xiang-wang-US/Competitive_Hovercraft/docs/Hovercraft_Case_Study.pdf

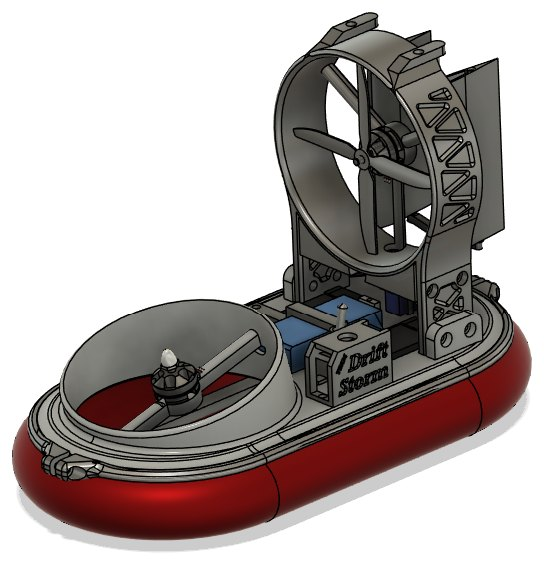
[picture p15: figure]

Context
ASME Design Team, Penn State (Team Driftstorm)

Dates
2024 to 2025 season,
competition March 2025

My role
Lead engineer

Team
16 students

Tools
Fusion 360, Fusion simulation,

weighted decision matrix

Outcome
First place, Best Hovercraft

# Competition Hovercraft

Lead engineer for a 16 person ASME team. Our

$100 radio controlled hovercraft won Best

Hovercraft for 2024 to 2025.

I led design for a 16 person team building a radio

controlled hovercraft on a $100 budget with a fixed kit

of motors and batteries. We went from a first flight

with four failure modes to a second revision that won

the competition. I ran the skirt material trade study,

set the rudder geometry, and drove the redesigns

after each test.

1st

place, Best Hovercraft 2024 to 2025
$100

budget beyond the standard kit
8 × 10

skirt trade study: materials by weighted criteria

Project

### Competition Hovercraft

Sheet title
Overview

Engineer
Xiang Wang

Date
2024 to 2025

Sheet

# Brief and constraints

Every team received the same MT2204 2300 KV

motors, 40 A ESCs, and 11.1 V LiPo battery, and

could not buy stronger replacements. Everything

else had to fit in $100 across two semesters, and

teams had to model their own reference parts

instead of importing them. The competition scored

drag races and a precision course.

The team settled on one chassis, one lift fan, one

thrust fan with twin rudders, and one skirt. I built the

reference models for the motor and skirt and

documented the wiring diagram.


2.1 First revision

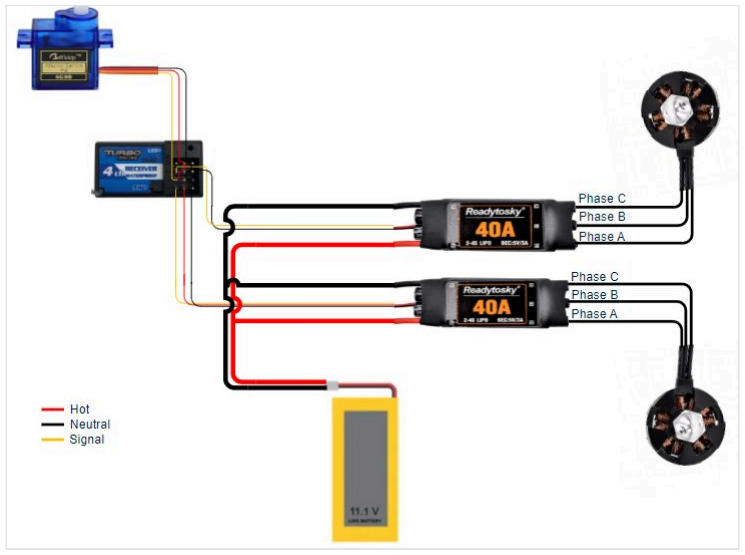
[picture p16: figure]

2.2 Wiring diagram: receiver, servos, two ESCs, lift and thrust motors

Project

Sheet title
Brief and constraints

Engineer
Date

Sheet

# Skirt material trade study

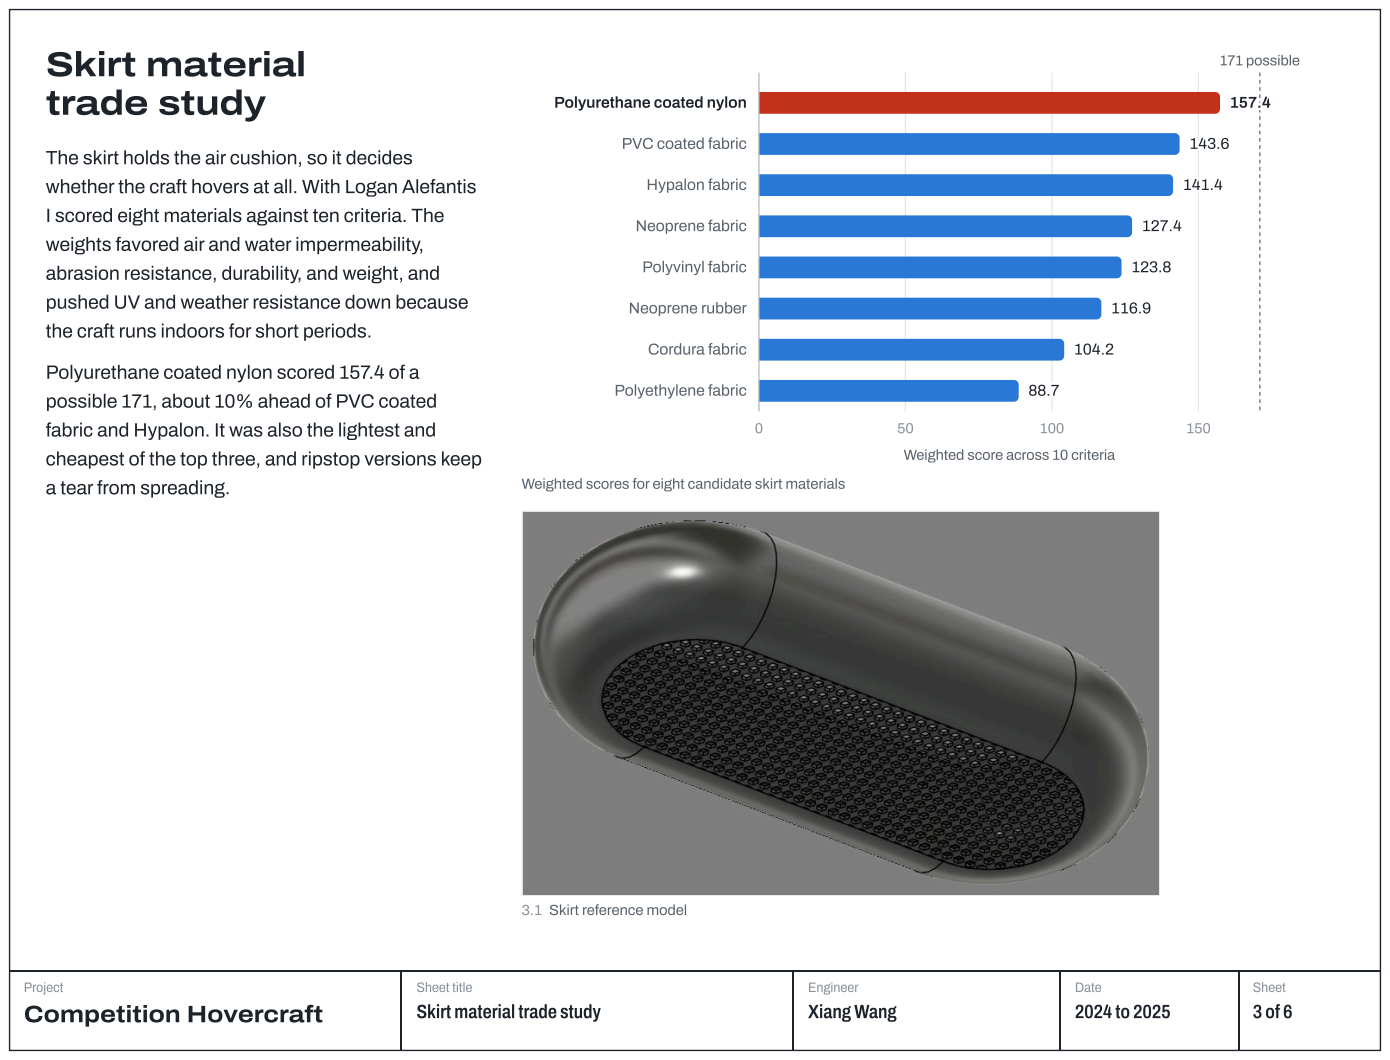
[picture p17: page 3]
171 possible; Polyurethane coated nylon; PVC coated fabric; Hypalon fabric; Neoprene fabric; Polyvinyl fabric; Neoprene rubber; Cordura fabric; Polyethylene fabric; Project; Engineer; Date; Sheet

The skirt holds the air cushion, so it decides

whether the craft hovers at all. With Logan Alefantis

I scored eight materials against ten criteria. The

weights favored air and water impermeability,

abrasion resistance, durability, and weight, and

pushed UV and weather resistance down because

the craft runs indoors for short periods.

Polyurethane coated nylon scored 157.4 of a

possible 171, about 10% ahead of PVC coated

fabric and Hypalon. It was also the lightest and

cheapest of the top three, and ripstop versions keep

Weighted score across 10 criteria

a tear from spreading.

Weighted scores for eight candidate skirt materials

3.1 Skirt reference model

Sheet title
Skirt material trade study

# Rudders and steering

A vector sketch of the thrust stream across a

deflected rudder showed the turning force peaks at

45 degrees. I capped rudder travel at plus or minus

45 degrees, so the servos and linkage only had to

cover that range.

The plastic rudder pins kept breaking, so titanium

rods replaced them for about $7. I also designed a

custom servo horn with the spline modeled in,

replacing the supplied horn to save parts, assembly,

and weight. The spline was too small to measure

directly, so I took a reference diameter and drew the

teeth by hand in CAD. FDM printers could not hold

the teeth, so the horn needed resin printing.


4.1 Thrust deflection sketch used to

set travel


4.2 Rudders at the 45 degree limit


4.3 Custom servo horn spline

Project

Sheet title
Rudders and steering

Engineer
Date

Sheet

# First flight and redesign

The first flight showed four problems: the craft

bobbed, thrust pushed the bow into the floor, the

angled lift fan behaved unpredictably, and the skirt

pulled out of its clamp. Looking at the clamp, force

concentrated near the fasteners and left the long

edges loose, so I proposed a continuous clamp with

a compliant strip pressing the skirt evenly.

Revision two changed three things: a flat fan

instead of the angled one, better component

placement, and an angled propeller. I proposed an

isogrid propulsion duct to cut weight, reworked the

rudder, servo, and leg mounts, and removed a bulky

part that was not needed, checking the lighter

structure in simulation.

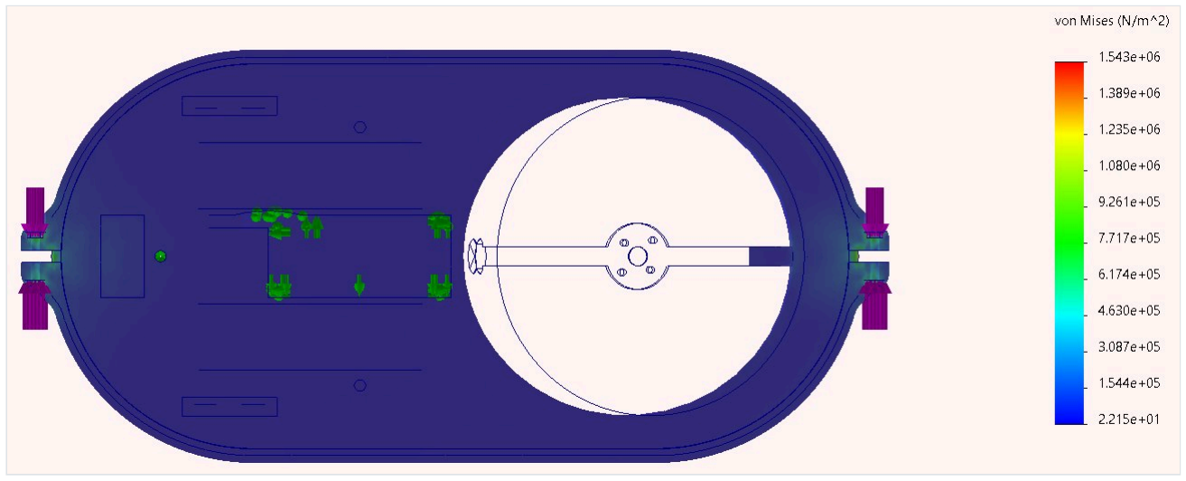
[picture p18: figure]

5.1 Clamp load: force only near the ends

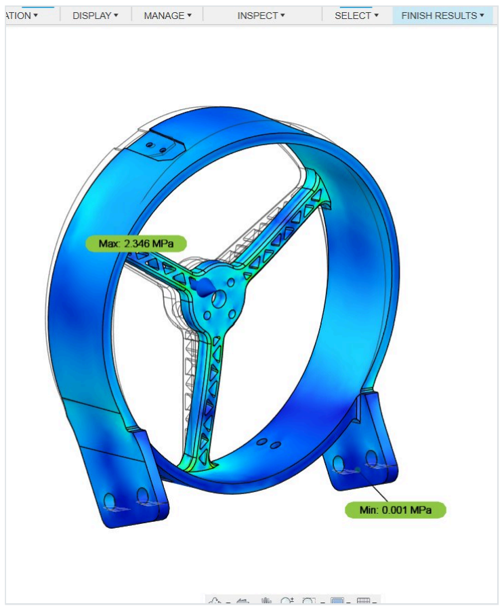
[picture p19: figure]

5.2 Isogrid thrust duct | 5.3 Duct stress check

Project

Sheet title
First flight and redesign

Engineer
Date

Sheet

# Testing and result

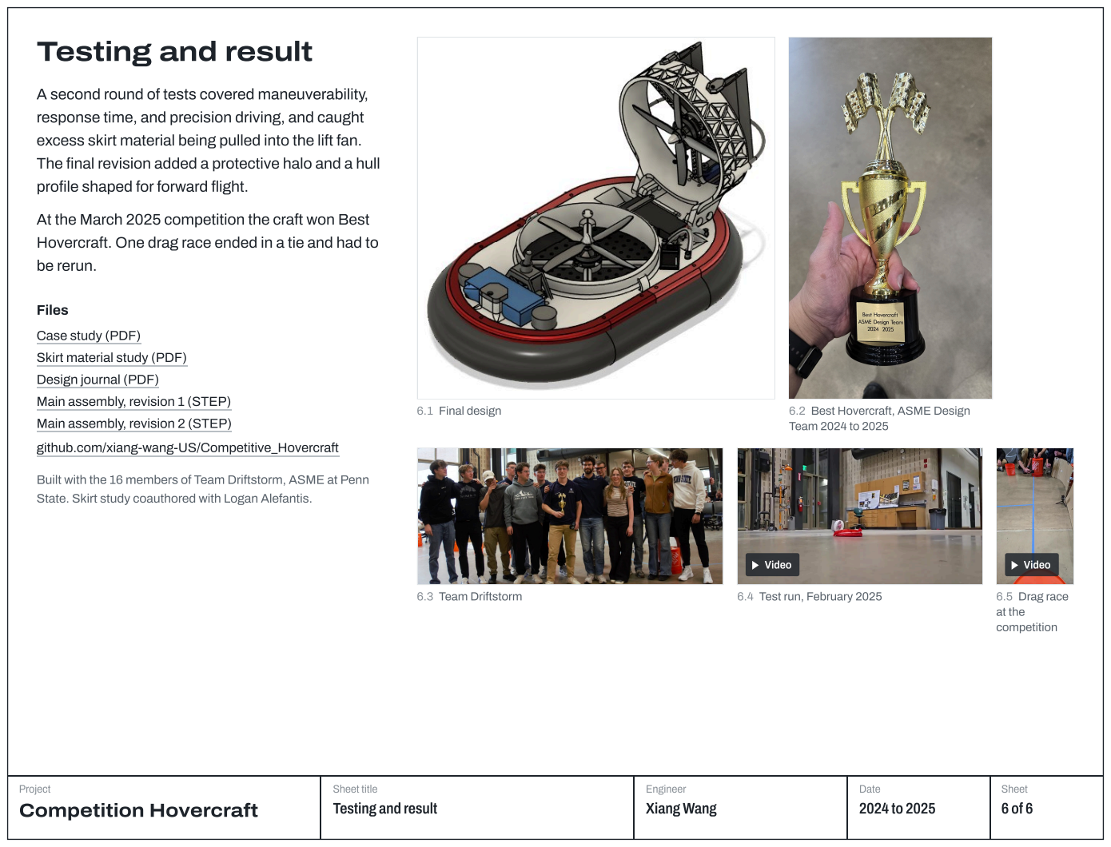
[picture p20: page 6]
be rerun.; Files; 6.1 Final design; 6.2 Best Hovercraft, ASME Design; Team 2024 to 2025; 6.3 Team Driftstorm; 6.4 Test run, February 2025; 6.5 Drag race; at the; competition; Project; Engineer; Date; Sheet; Video

A second round of tests covered maneuverability,

response time, and precision driving, and caught

excess skirt material being pulled into the lift fan.

The final revision added a protective halo and a hull

profile shaped for forward flight.

At the March 2025 competition the craft won Best

Hovercraft. One drag race ended in a tie and had to

Case study (PDF) (https://github.com/xiang-wang-US/Competitive_Hovercraft/blob/main/docs/Hovercraft_Case_Study.pdf)

Skirt material study (PDF) (https://github.com/xiang-wang-US/Competitive_Hovercraft/blob/main/docs/Hovercraft_Skirt_Material_Study.pdf)

Design journal (PDF) (https://github.com/xiang-wang-US/Competitive_Hovercraft/blob/main/docs/Hovercraft_Design_Journal.pdf)

Main assembly, revision 1 (STEP) (https://github.com/xiang-wang-US/Competitive_Hovercraft/blob/main/cad/Hovercraft_Main_Assembly_V1.step)

Main assembly, revision 2 (STEP) (https://github.com/xiang-wang-US/Competitive_Hovercraft/blob/main/cad/Hovercraft_Main_Assembly_V2.step)

github.com/xiang-wang-US/Competitive_Hovercraft

Built with the 16 members of Team Driftstorm, ASME at Penn

State. Skirt study coauthored with Logan Alefantis.

Sheet title
Testing and result
