xiang-wang-US/Competitive_Hovercraft/cad/Hovercraft_Main_Assembly_V2.step

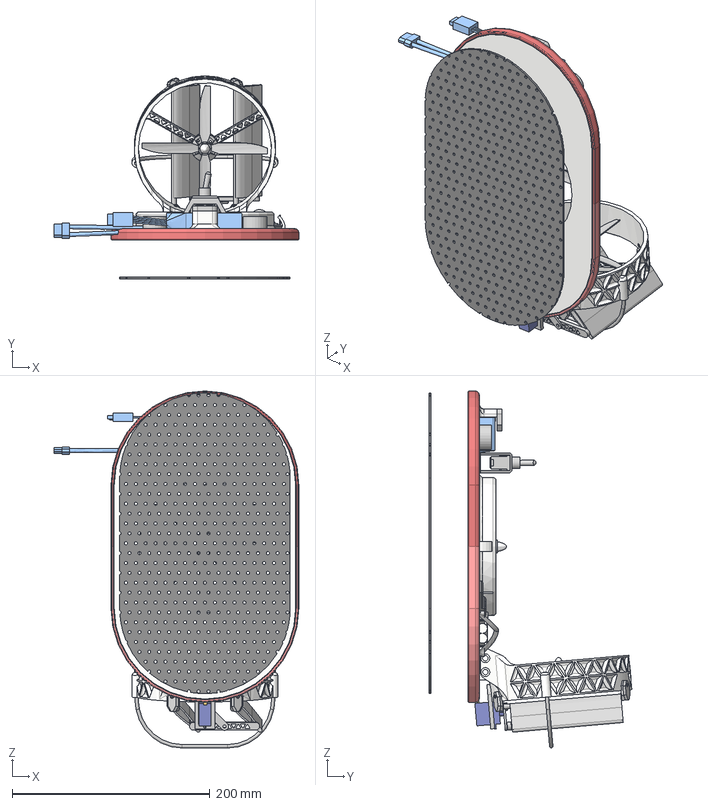
[picture p22: CAD file, 2026-10-12]
cad/Hovercraft_Main_Assembly_V2.step
247.8 x 205.7 x 361.5 mm
MT2204 2300 KV - Xiang x 2
4 Blade Propellers - Jess Portman x 2
Penny Caps x 2
Penny-Alex x 2
Battery Cap
O-Ring
Battery Reference Part
ESC refrence part2 x 2
Reference Receiver- Matthew Devonshire
Kill Switch - Logan Alefantis
Skirt Model V2 - Alex
KIll Switch Mount V2 - Logan Alefantis
Propulsion Bracket Rudder Mount B x 2
Propulsion Bracket Rudder Mount A x 2
M3 Washer x 5
Aileron x 2
EXP - Servo Horn Driver Unit
Titanium Rod M3x128.5 x 2
M2x6 x 4
Motion Linkage Bracket
Clamp Redesign- Evan
