xiang-wang-US/Competitive_Hovercraft/cad/Hovercraft_Main_Assembly_V1.step

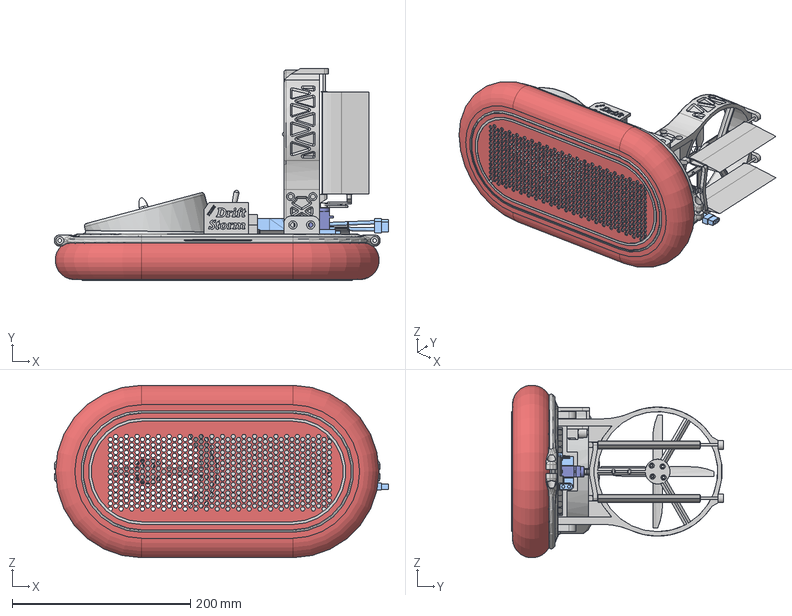
[picture p23: CAD file, 2026-10-12, an earlier design]
cad/Hovercraft_Main_Assembly_V1.step
375.3 x 238.3 x 193.7 mm
Skirt Model - PM - Xiang Wang
MT2204 2300 KV - Xiang x 2
ESC refrence part2 x 2
Battery Reference Part
Reference Receiver- Matthew Devonshire
skirt shape retainer idea - Jess Portman
Electronics Bracket - George Kuney
Skirt Clamp Remake- George Kuney
M3 Washer x 6
EXP-Propulsion Servo Bracket
EXP-Propulsion Bracket
4 Blade Propellers - Jess Portman
Aileron x 2
EXP-Servo Motor Horn Adapter B
EXP-Servo Motor Horn Adapter A
EXP-Aileron Driver Bracket
EXP-Aileron Mounting Bracket x 2
Kill Switch Mount - Logan Alefantis
Kill Switch - Logan Alefantis
