xiang-wang-US/Competitive_Hovercraft/docs/Hovercraft_Design_Journal.pdf

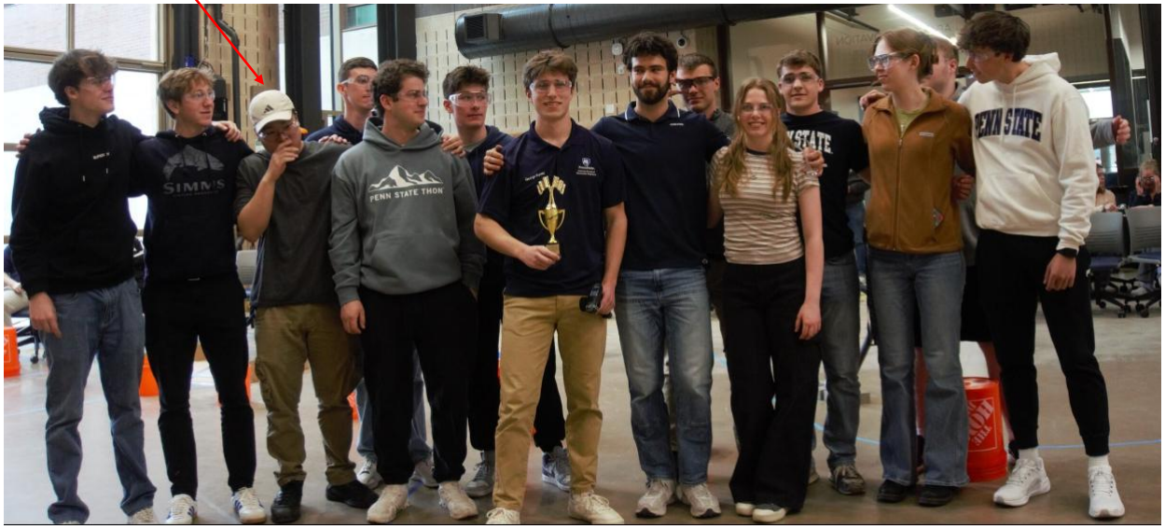
[picture p69: figure]
