xiang-wang-US/Competitive_Hovercraft/docs/Hovercraft_Design_Journal.pdf

# Hovercraft Competition

## ASME PSU 2025 From the perspectives of Xiang

# Preface

- This document is not necessarily formatted in any particular way.

## - It contains:

## - Documented work - Explanations to others - General Progress

## - It mostly contains my perspective on how the project progressed - Some major time stamps have been noted for story purposes

# Competition Detail

## - Each team are given a standard set of parts

## - Motors, Batteries, ESCs

## - Not allowed to buy stronger standard parts - Can rebuy fried parts and will not count toward budget - 100 USD - 2 semesters - No importing reference parts

# Brainstorming Session

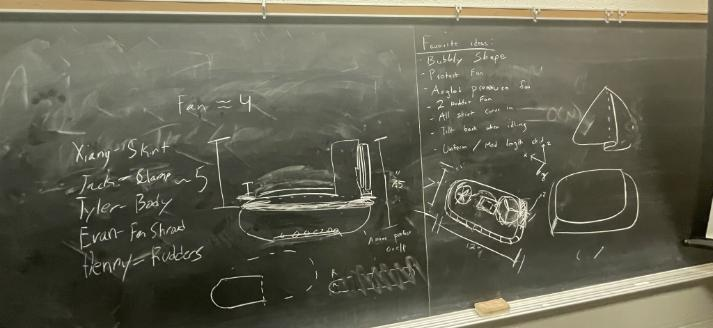
[picture p24: figure]

# Brainstorming Session Summary

## - The hover craft will have - 1 Chassis - 1 Propeller Fan - 1 Lift fan - 1 Skirt

## We like having a rudder, angled lift fan, and forward lift fan

# Making Reference Parts (MT2204 – 2300 KV)

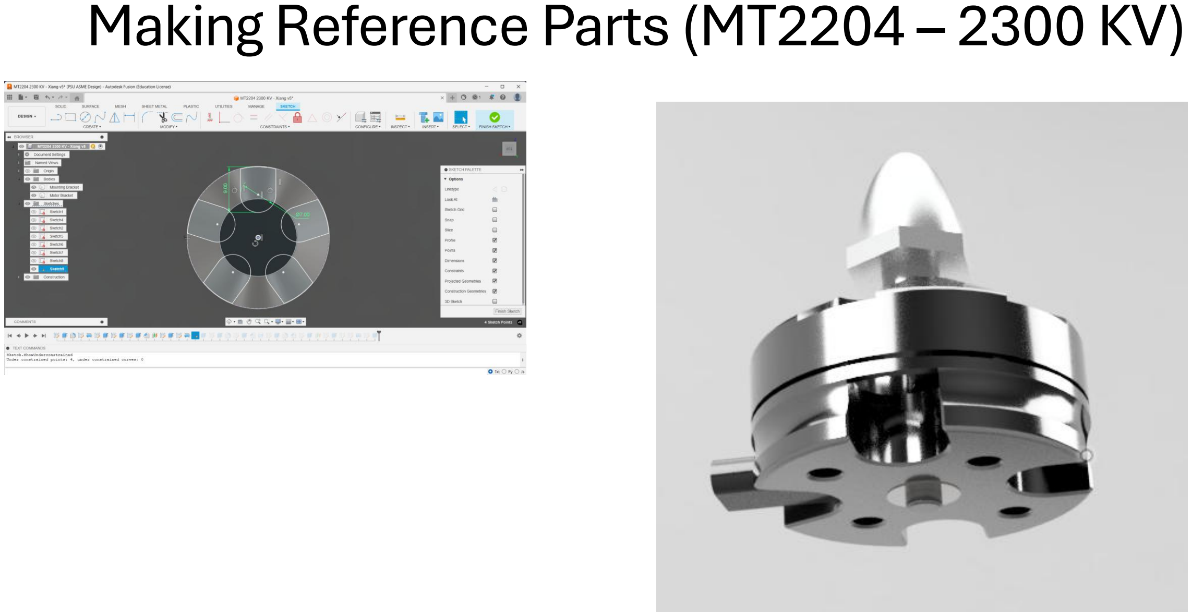
[picture p25: page 6]

# Making the Skirt Reference

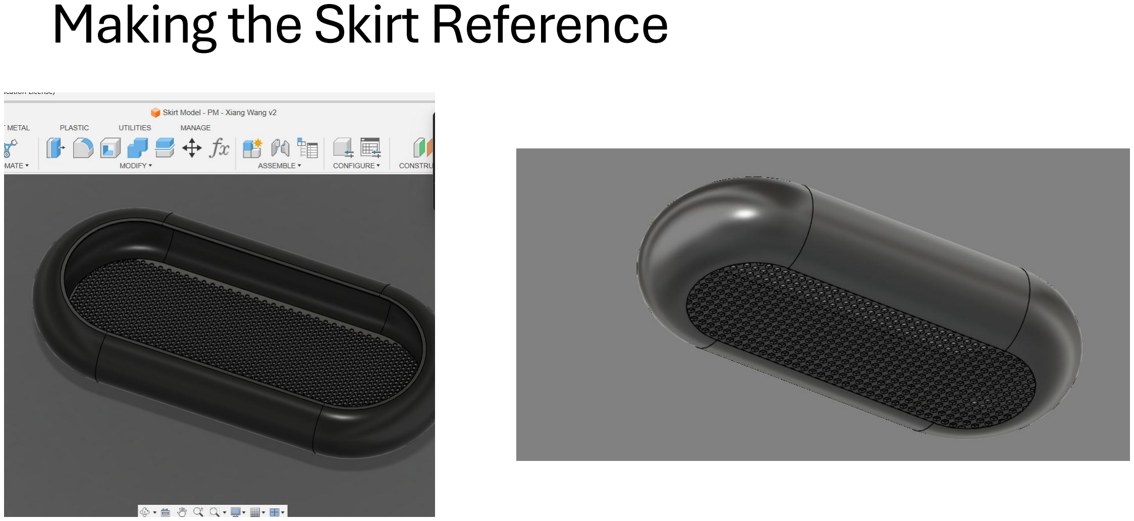
[picture p26: page 7]

# Wiring Diagram

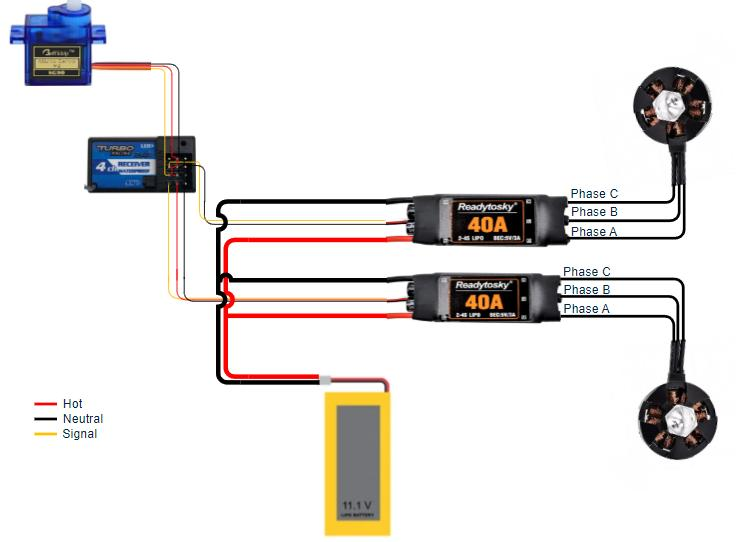
[picture p27: figure]

# Does this work?

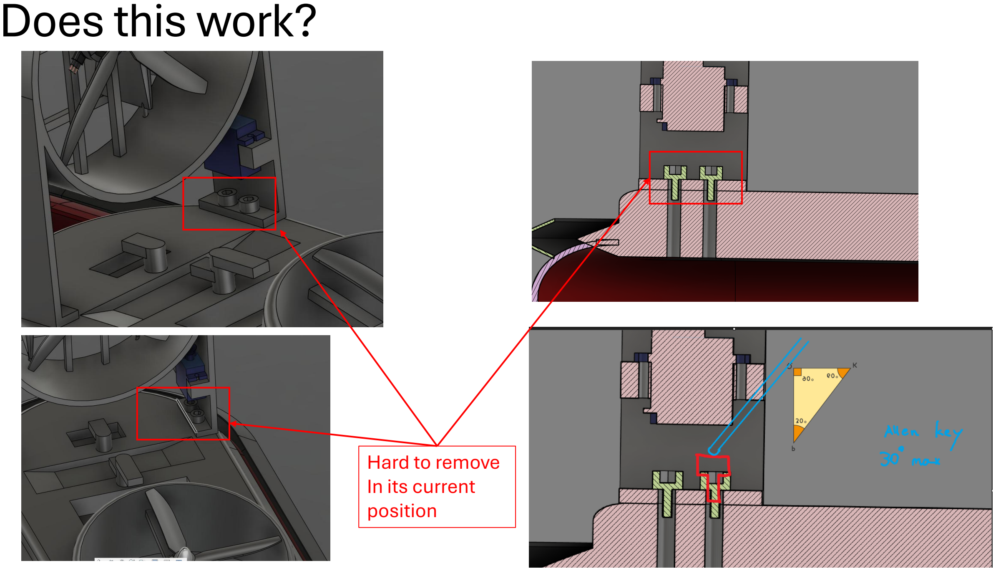
[picture p28: page 9]

Hard to remove
In its current
position

# Let’s remove these

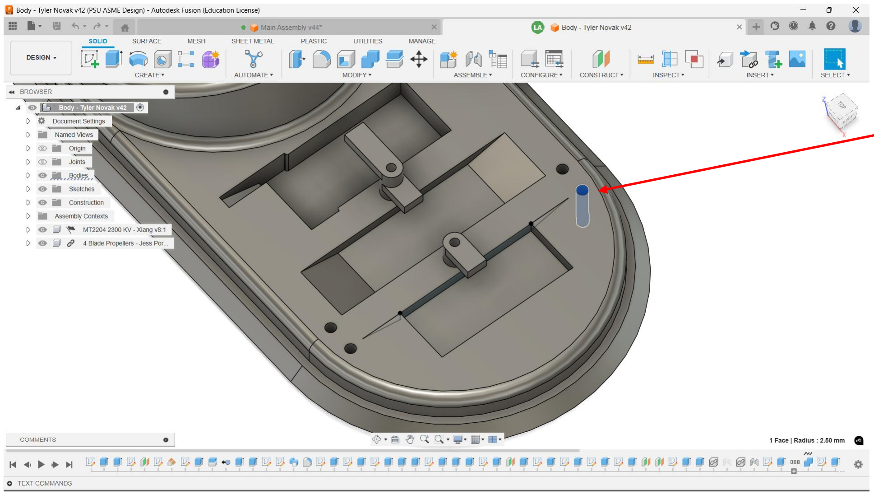
[picture p29: figure]

Let’s
change
these

# Raised Mounting Point Suggestion

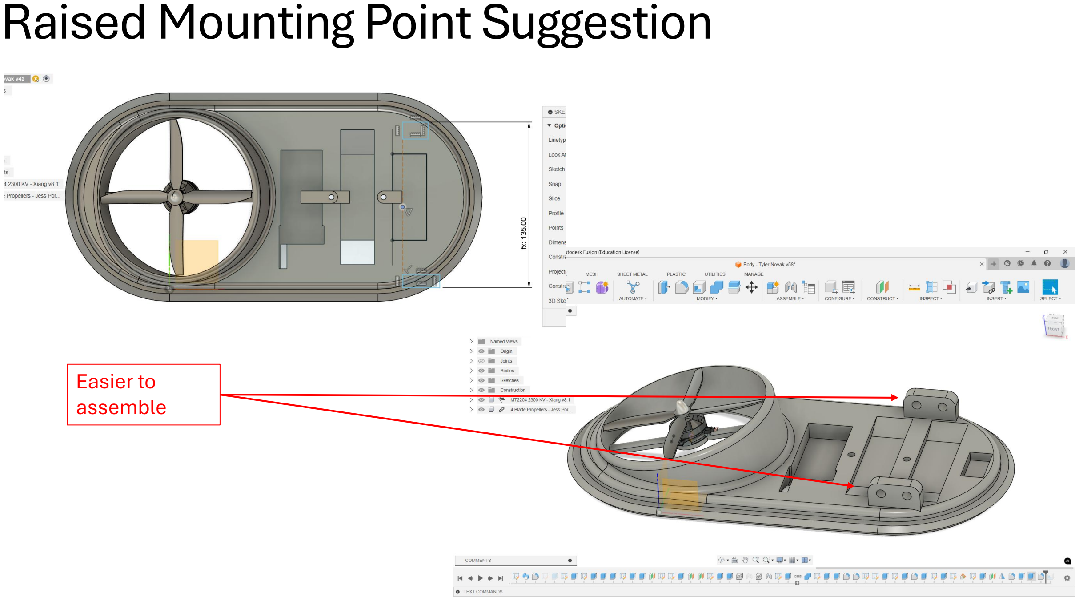
[picture p30: page 11]

Easier to
assemble

# Maximum angle needs

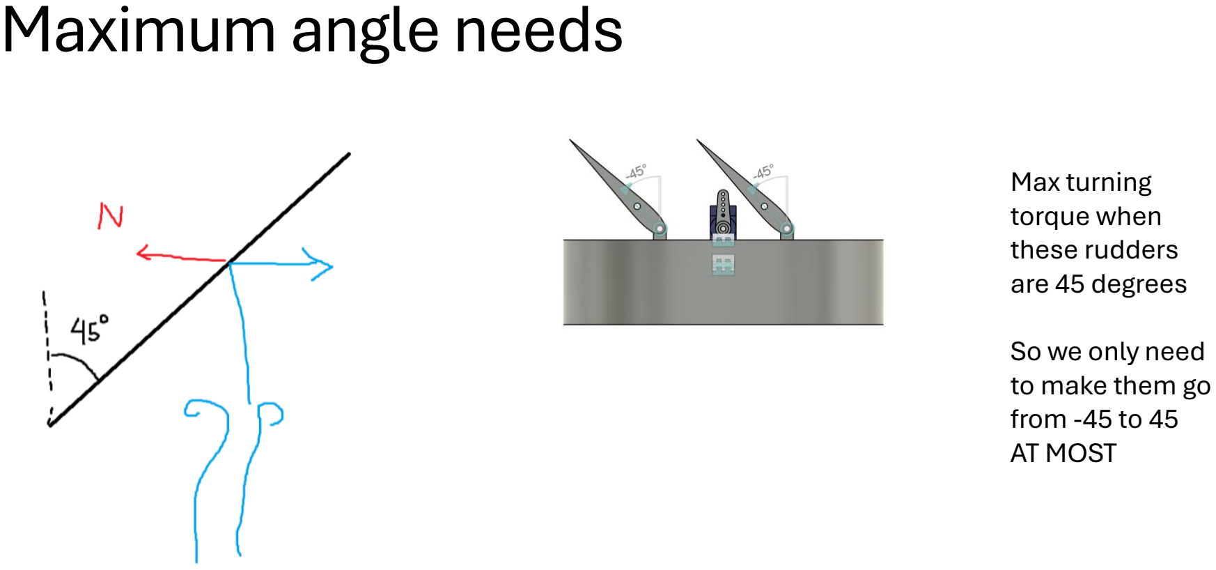
[picture p31: page 12]

Max turning
torque when
these rudders
are 45 degrees

So we only need
to make them go
from -45 to 45
AT MOST

# V1 Completion

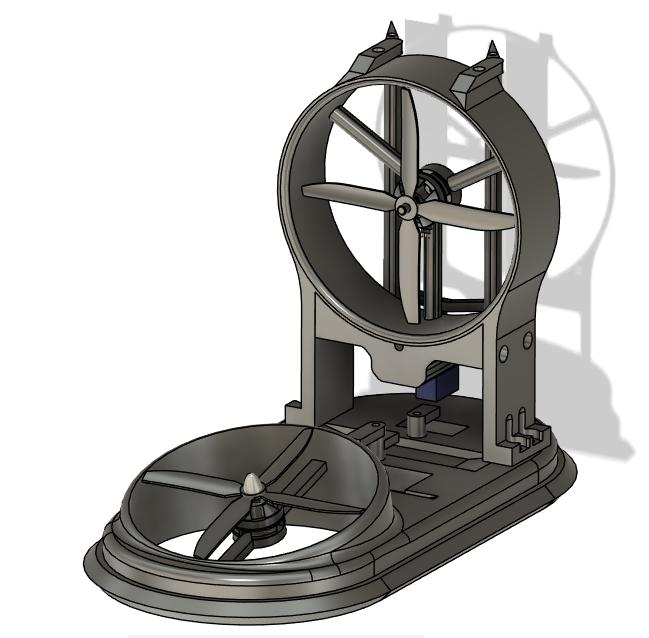
[picture p32: figure]

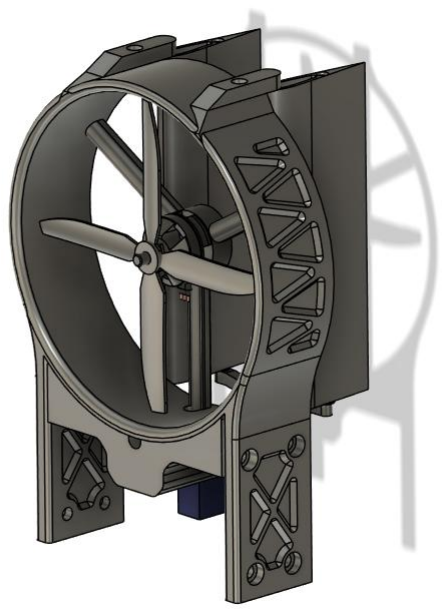
[picture p33: figure]

# Isogrids Proposal?

- May help with weight
reduction
- Looks kind of cool

# Current Component Layout

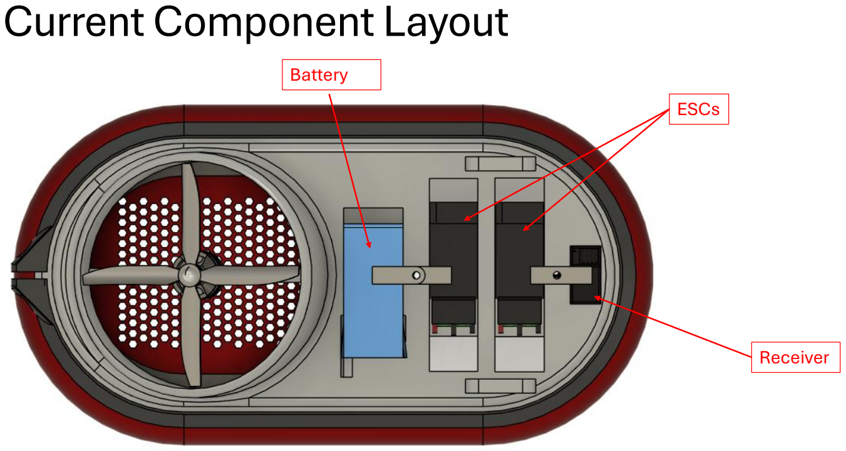
[picture p34: page 15]

ESCs

Receiver

Battery

# Component Interference

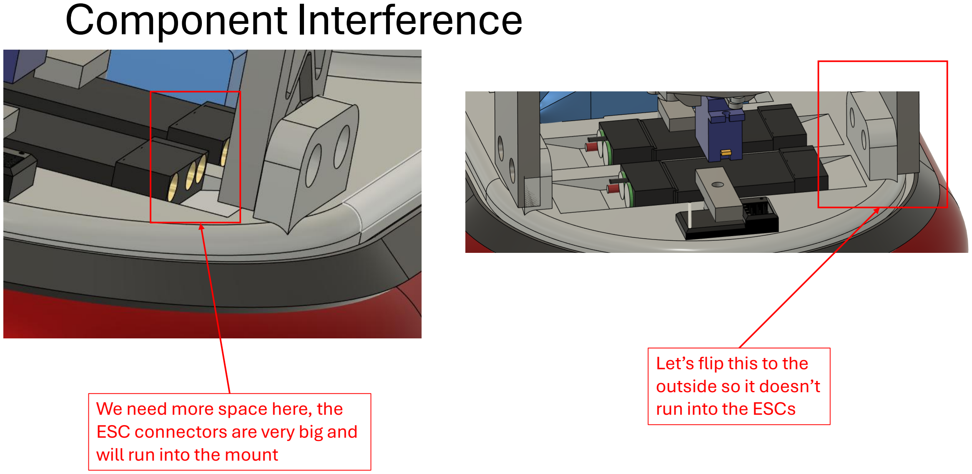
[picture p35: page 16]

We need more space here, the ESC connectors are very big and will run into the mount

Let’s flip this to the
outside so it doesn’t
run into the ESCs

# First flight!

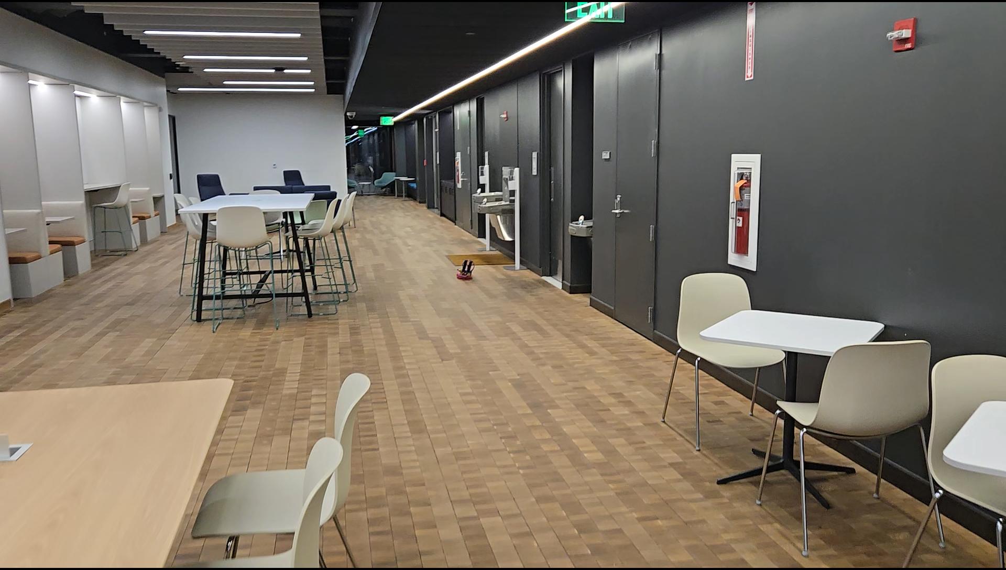
[picture p36: figure]

# First Flight Issues

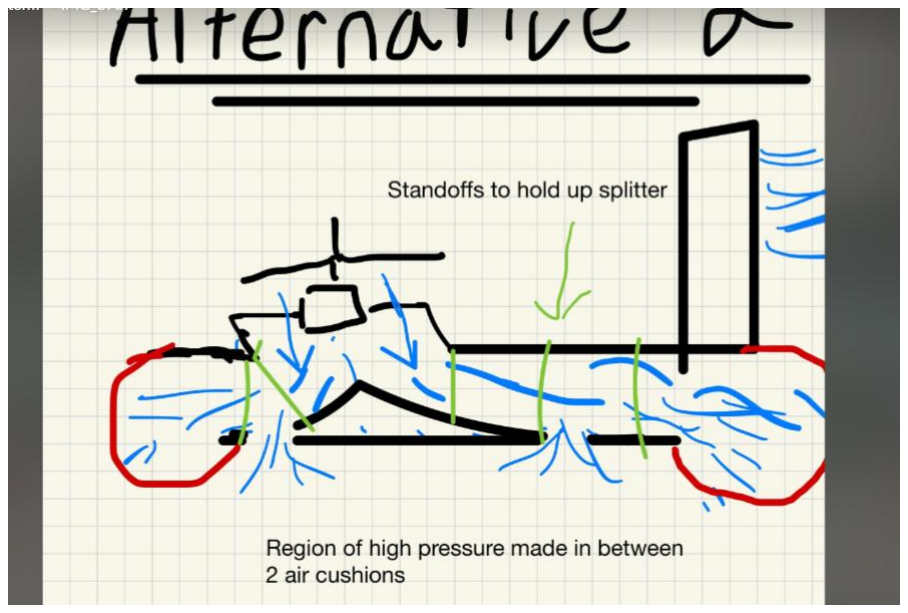
[picture p37: figure]

The propeller were pushing the hovercraft into the
ground.

Angled lift fan was also kind of odd

The hovercraft skirt kept
coming out

Bobbing issue, maybe this might help

# Clamping Force Issues

This fan design only
applies force near the
ends

Little to no force
here

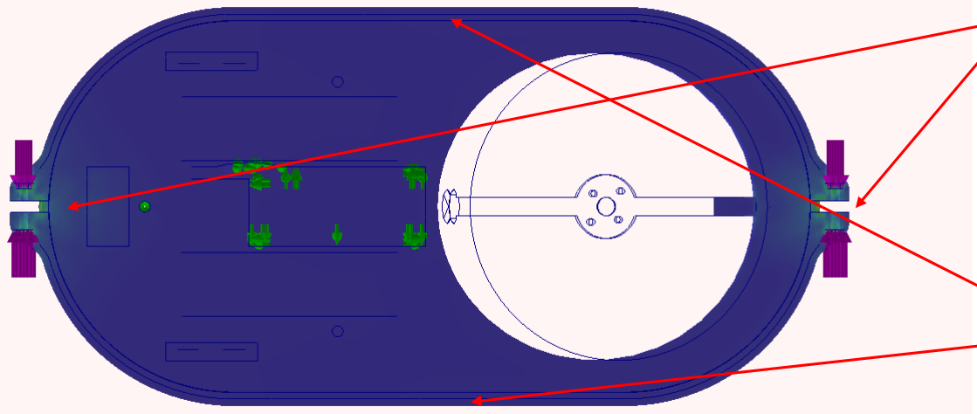
[picture p38: figure]

This reminds me of the problem I saw in this video from years ago lol https://youtu.be/1RJunnhpFIM

# Clamping redesign force proposal

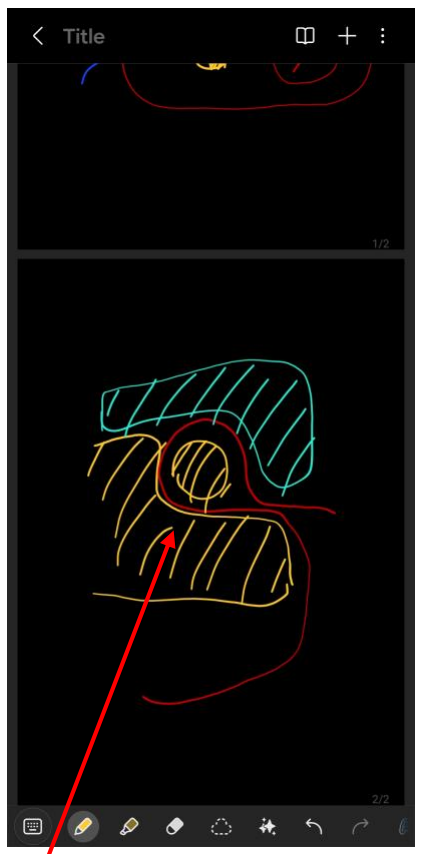
[picture p39: figure]
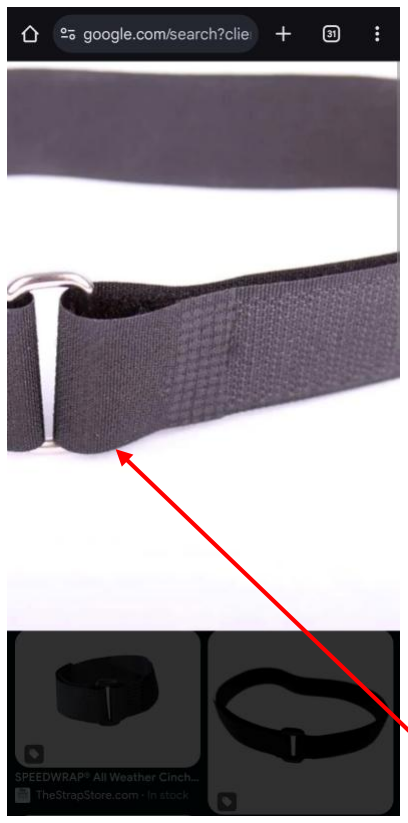
[picture p40: figure]

What if we did something
like this

Red is skirt

Yellow is chassis

Cyan is new clamp

And the circle is
some squishy
material to press of
it together

# Part too bulky

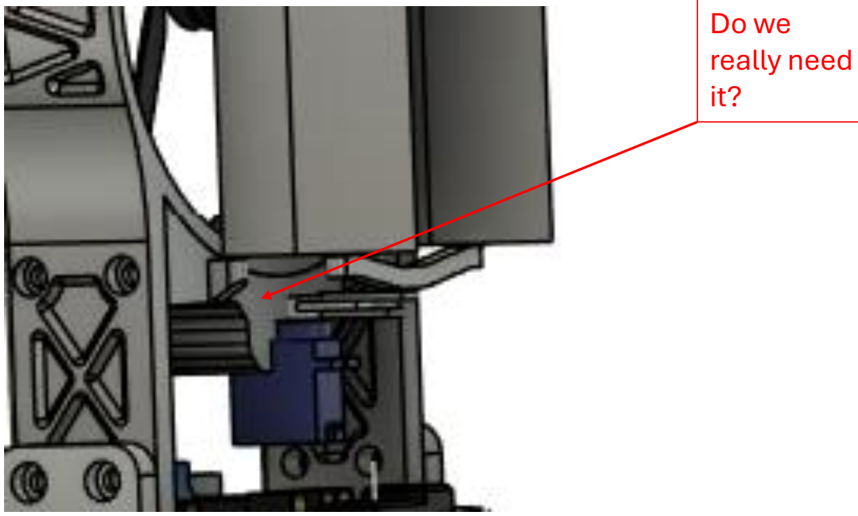
[picture p41: figure]
Do we really need it?

Benefits:
- Reduced weight
- Simplified parts
- Less assembly

Work:
- Need to make sure the legs are still strong (FEA?)

# New Propulsion Bracket Design Proposal

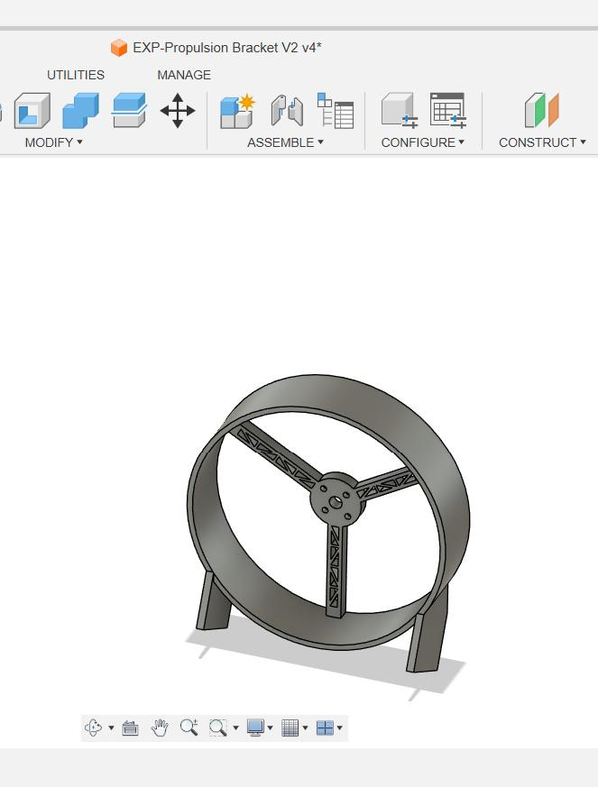
[picture p42: figure]

Redo
- Rudder Mount
- Servo Mount
- Leg Mount

# Isogrid Continuity Issue

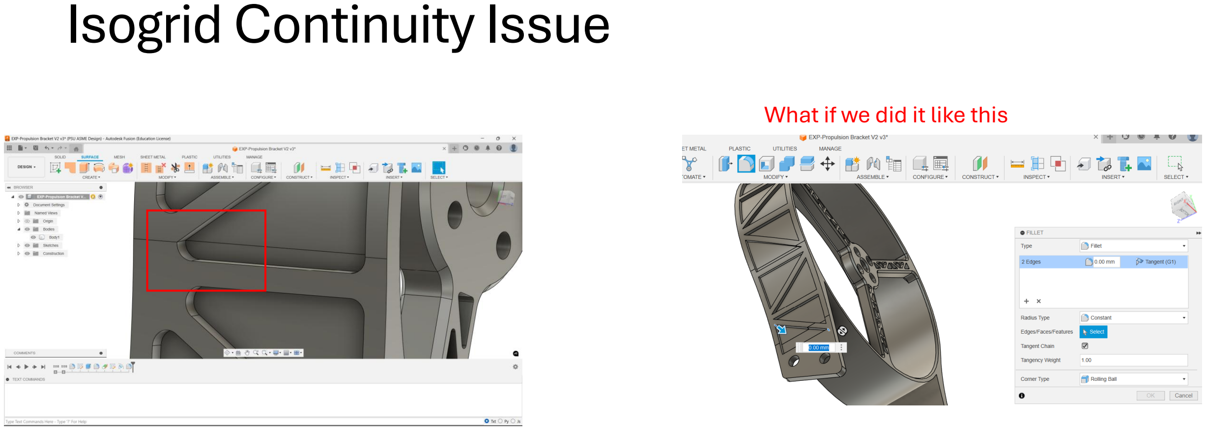
[picture p43: page 23]

What if we did it like this

# Isogrid Redesign

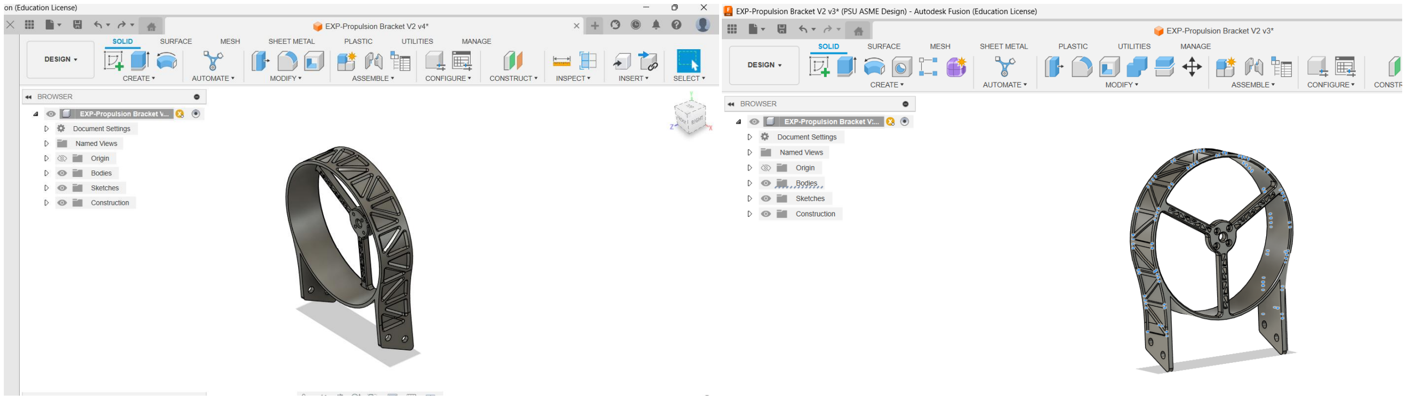
[picture p44: figure]

# Isogrid Redesign

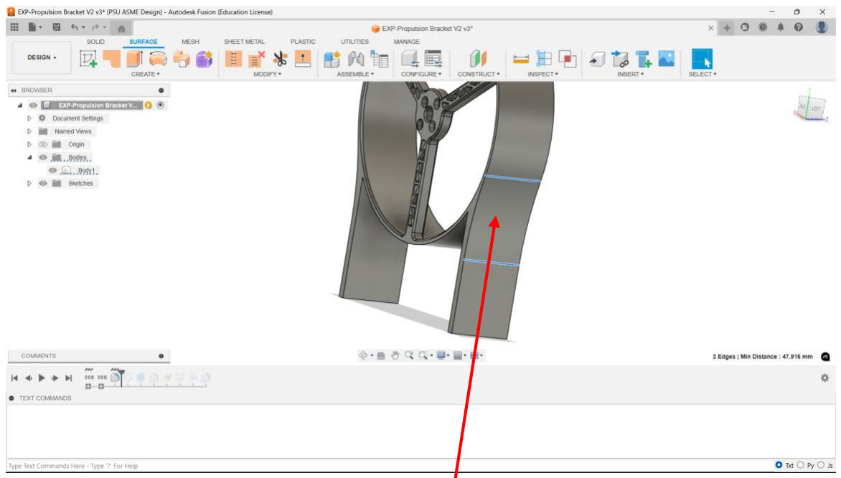
[picture p45: figure]

Nevermind isogrid can
be fixed by increasing
the radii here

# Redesigning the servo horn

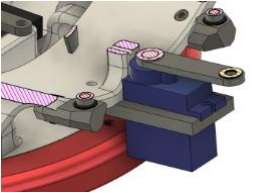
[picture p46: figure]

Benefits
- Much simpler. No more horn that was shipped with manufacturer.
- Reduced assembly
- Weighs less

Work
- We need to actually be able to manufacture it. No FDM printing; not enough resolution. Possible resin?

# We need custom Servo Horn

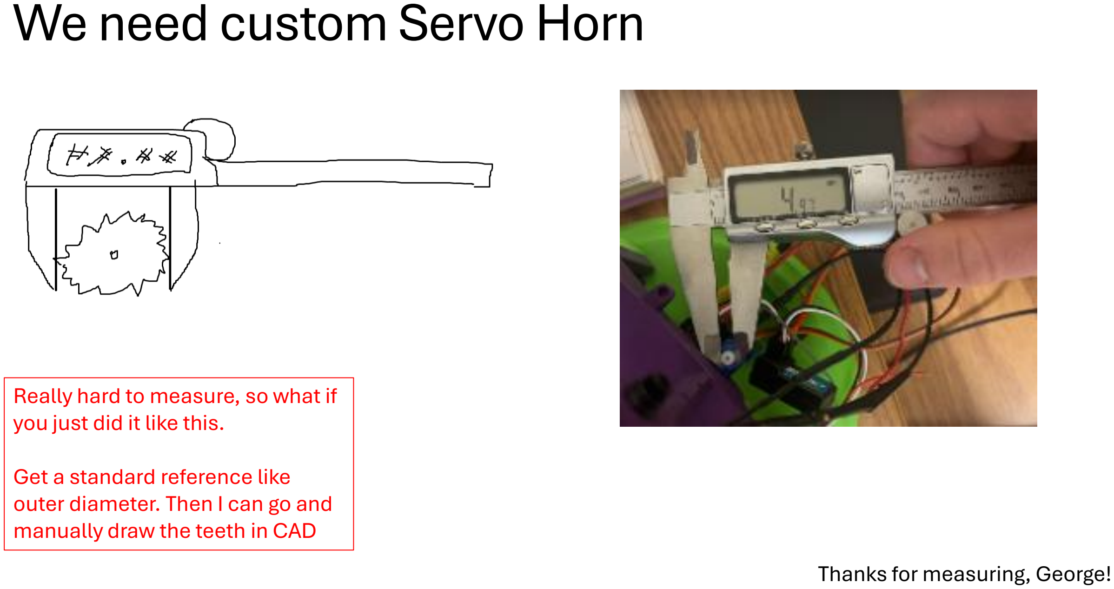
[picture p47: page 27]

Really hard to measure, so what if you just did it like this.

Get a standard reference like outer diameter. Then I can go and manually draw the teeth in CAD Thanks for measuring, George!

# Servo Spline Profile

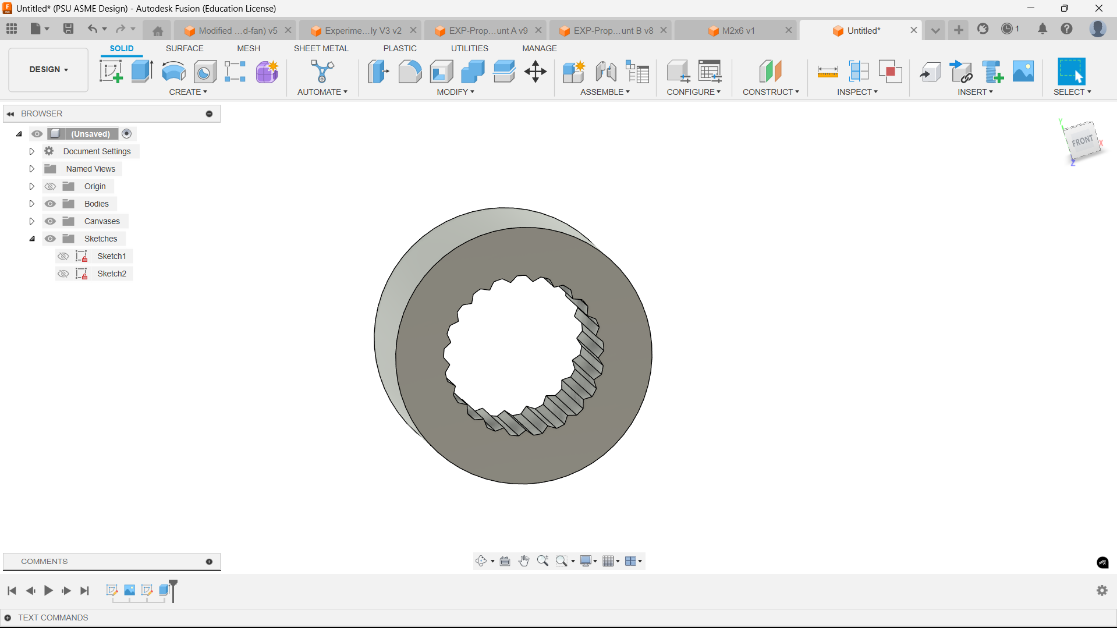
[picture p48: figure]

# Propulsion Bracket Recommendations

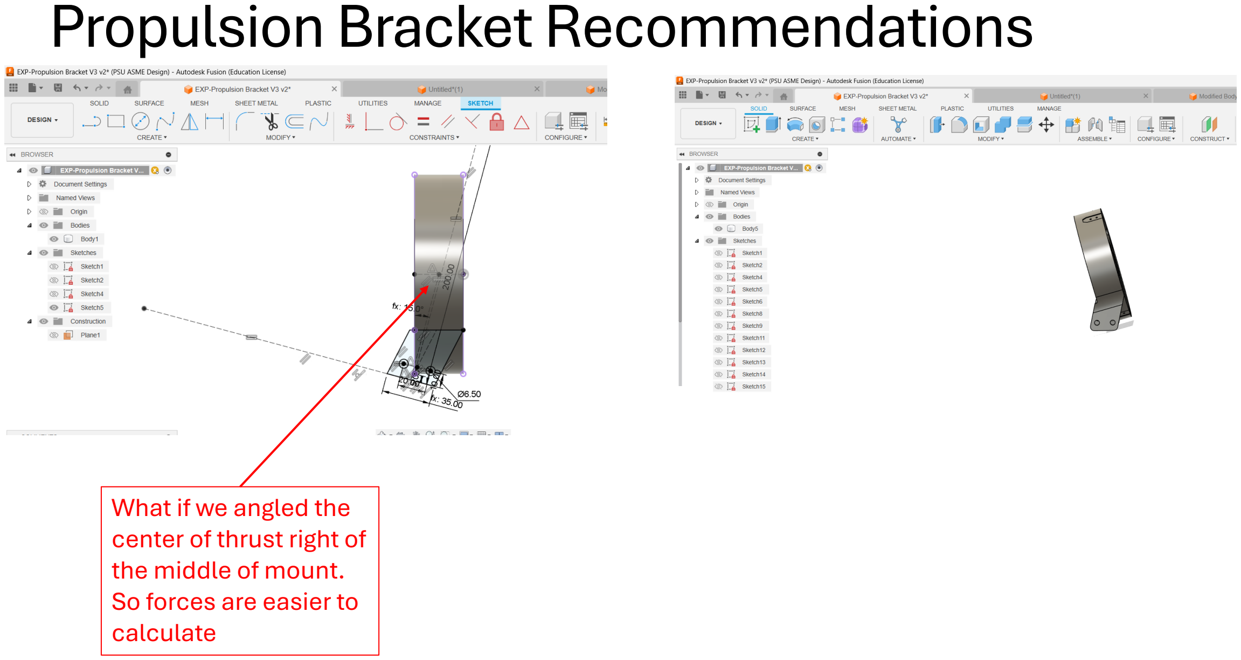
[picture p49: page 29]

What if we angled the
center of thrust right of
the middle of mount.
So forces are easier to
calculate

# V2 Changes

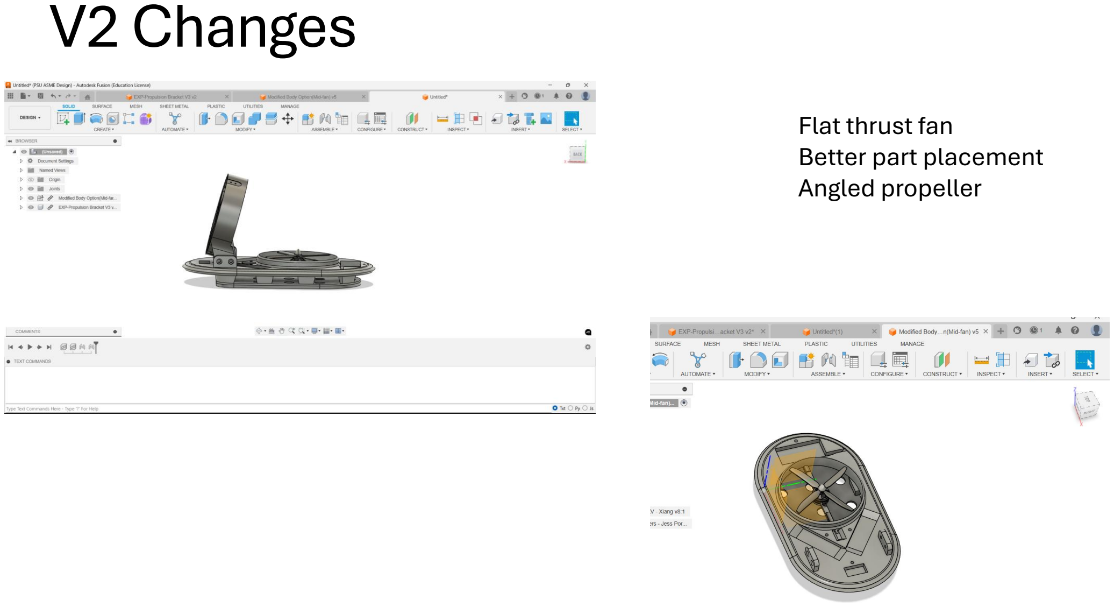
[picture p50: page 30]

Flat thrust fan
Better part placement
Angled propeller

# Rudder Rework!

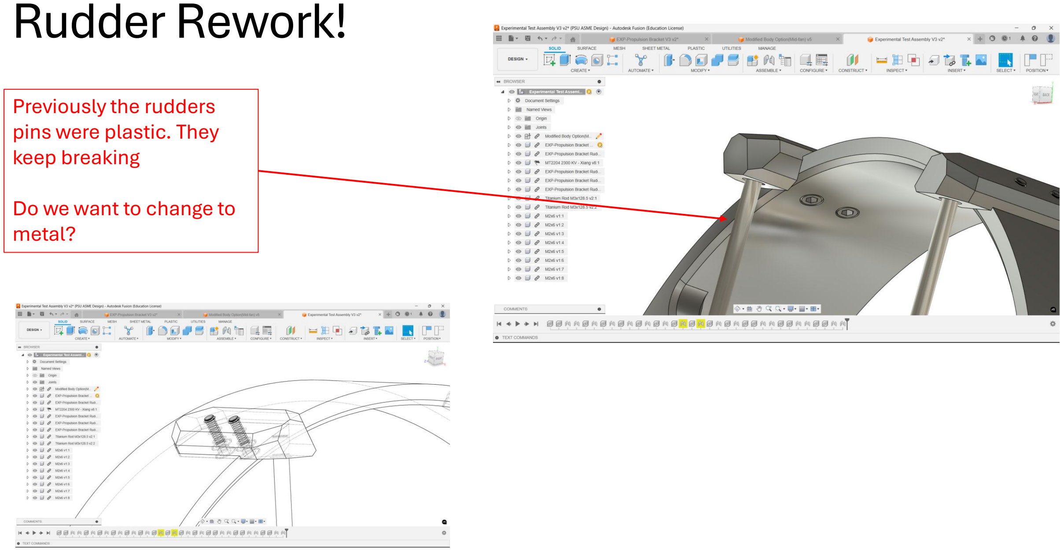
[picture p51: page 31]

Previously the rudders
pins were plastic. They
keep breaking

Do we want to change to
metal?

# Rudder Rework!

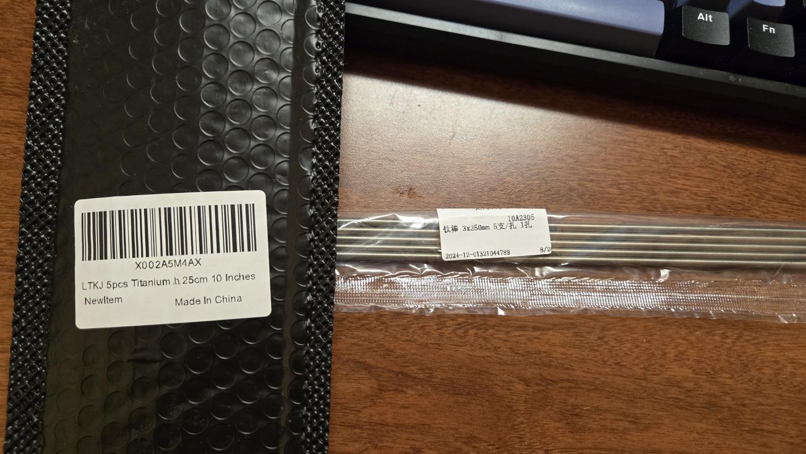
[picture p52: figure]

Check this out we got
titanium rods

They were only like 7 dollars too

# Thoughts on mounting the servo upside down?

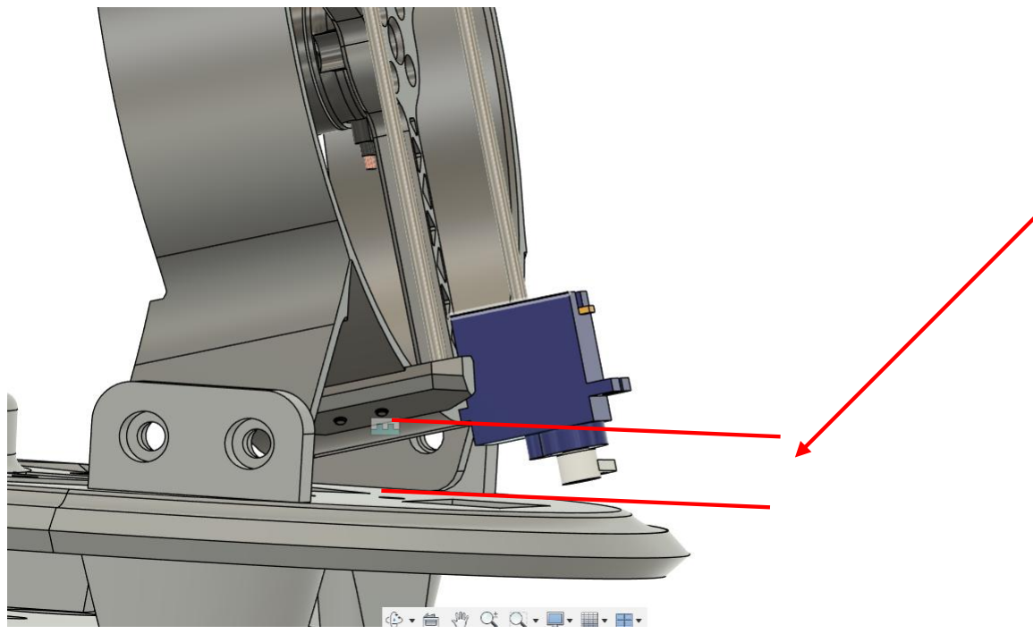
[picture p53: figure]

Might help the clearance here

Maybe not. It makes
the wiring too far. It
also stands very far
away.

# We can extend it over the edge instead but right side up

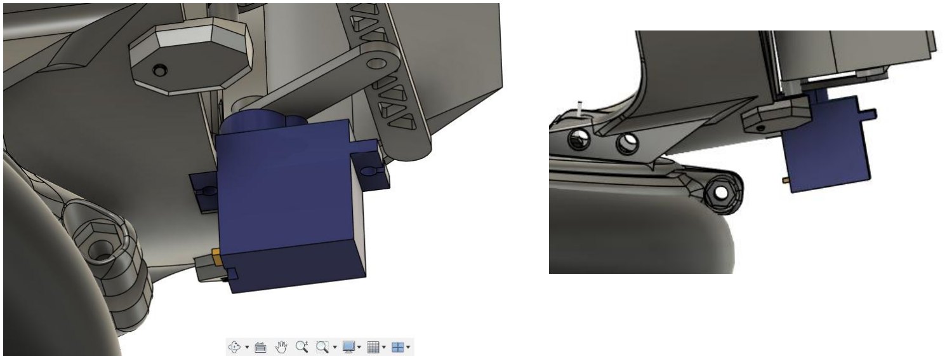
[picture p54: figure]

# I don’t think this is necessary

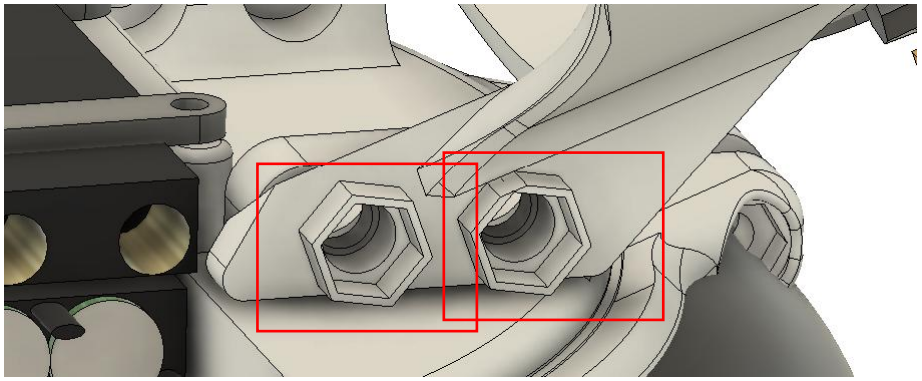
[picture p55: figure]

Definitely helps with
nut staying in place.

But friction is good
enough

# Testing 2! First video

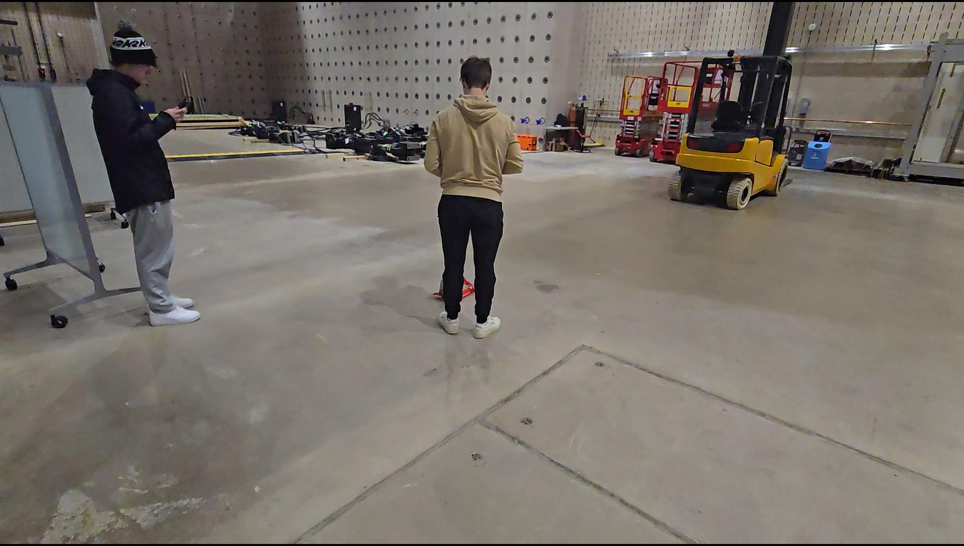
[picture p56: figure]

Testing
maneuverability

Response time

# Testing 2! Second video

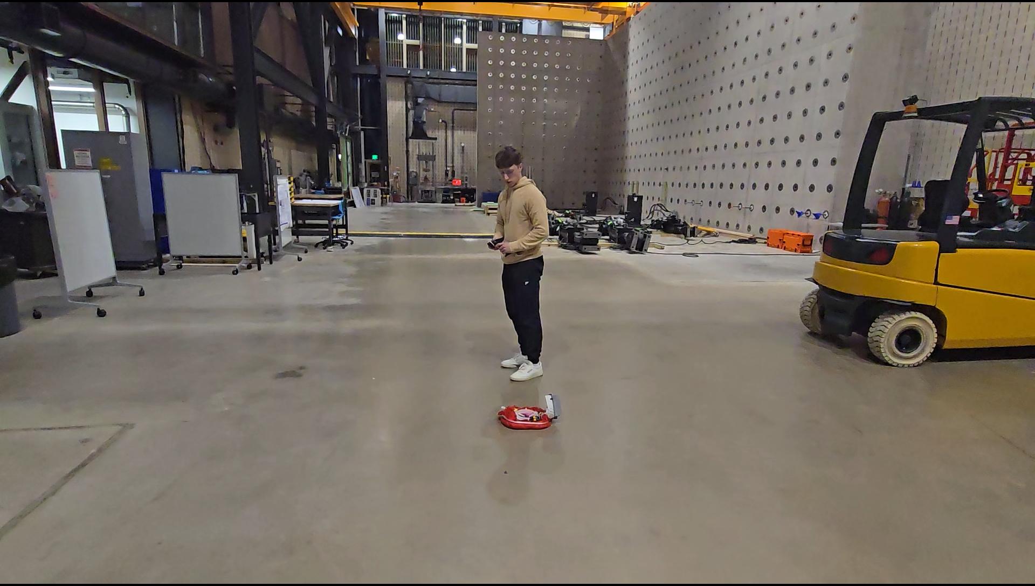
[picture p57: figure]

Excess skirt material
getting sucked into
lift fan

# Testing 2! Third Video

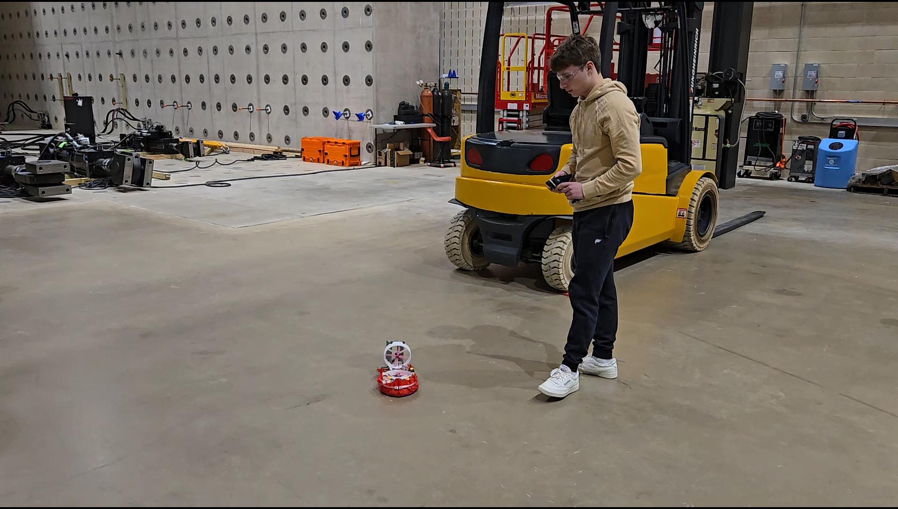
[picture p58: figure]

Precision testing

# oops

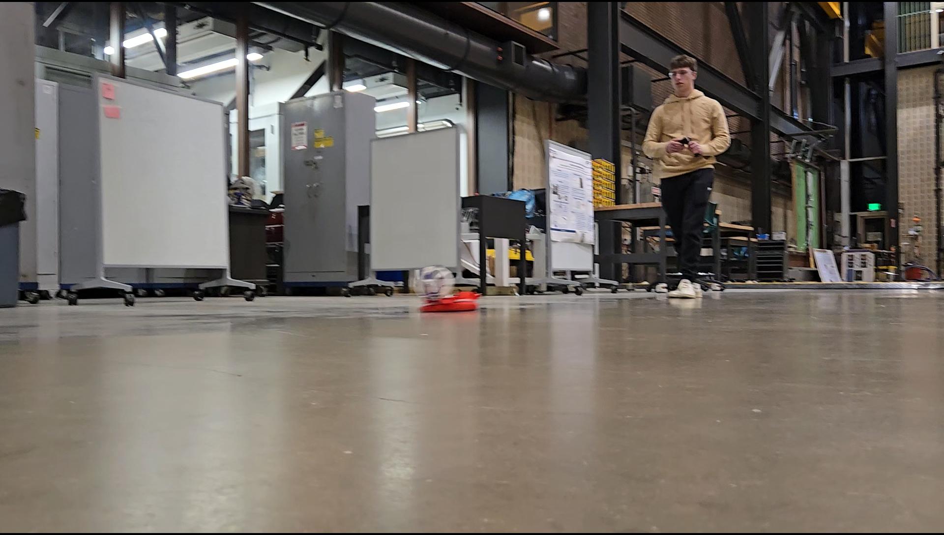
[picture p59: figure]

# Interference

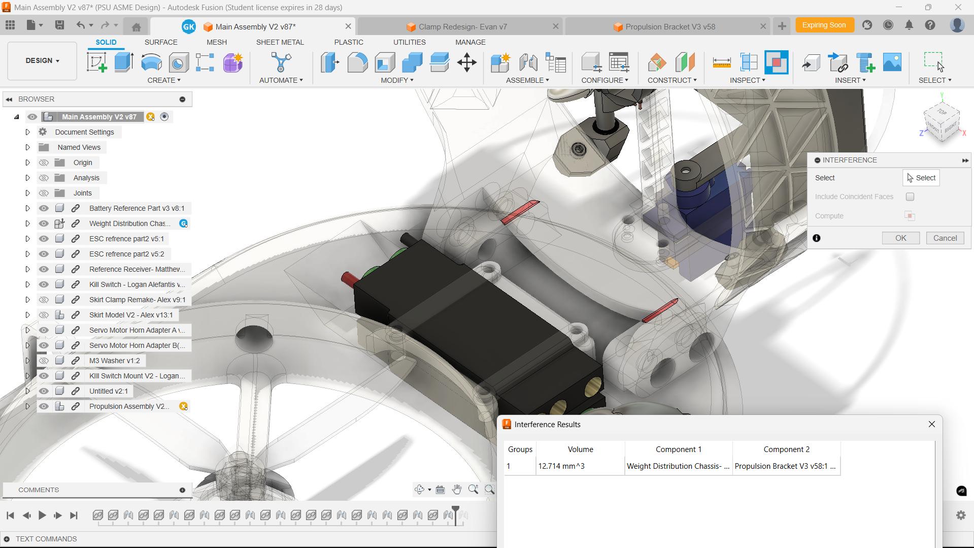
[picture p60: figure]

# Changes

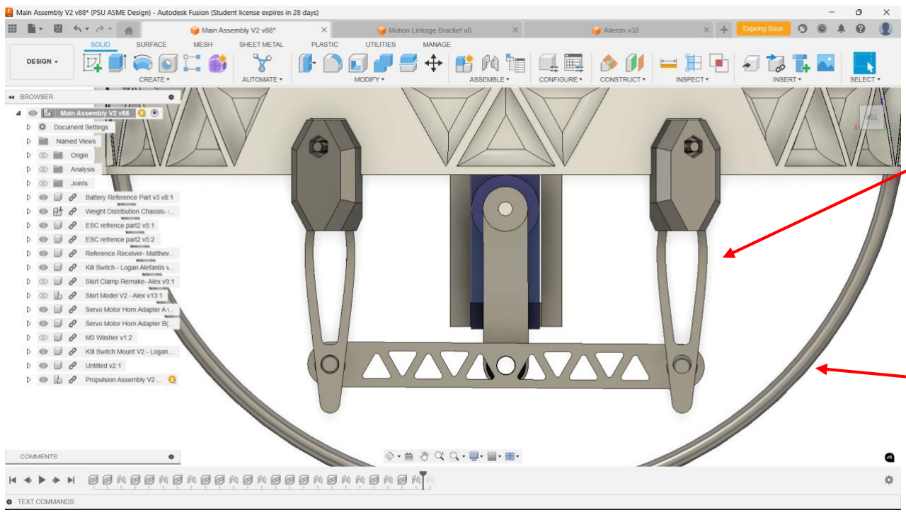
[picture p61: figure]

Made this profile
more efficient in
forward flight

Added
Protective Halo

# Final Design

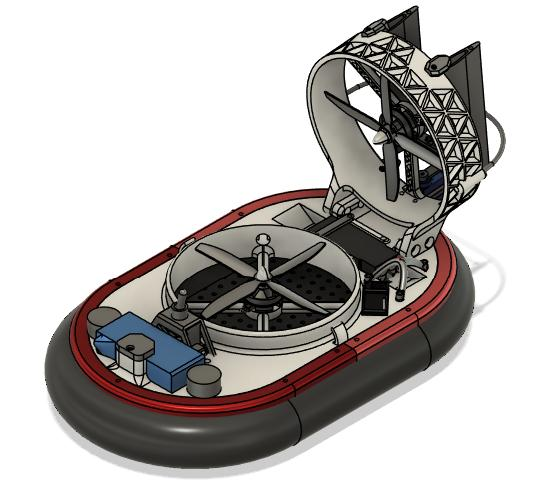
[picture p62: figure]

# Practice before comp day!

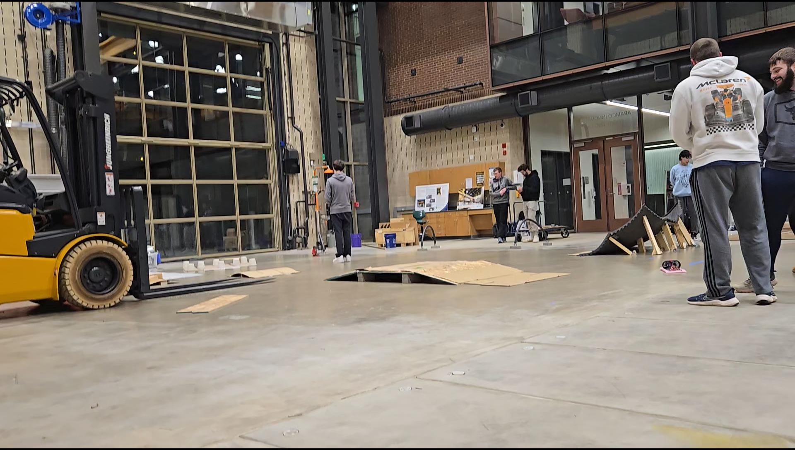
[picture p63: figure]

# Comp Day Footage!

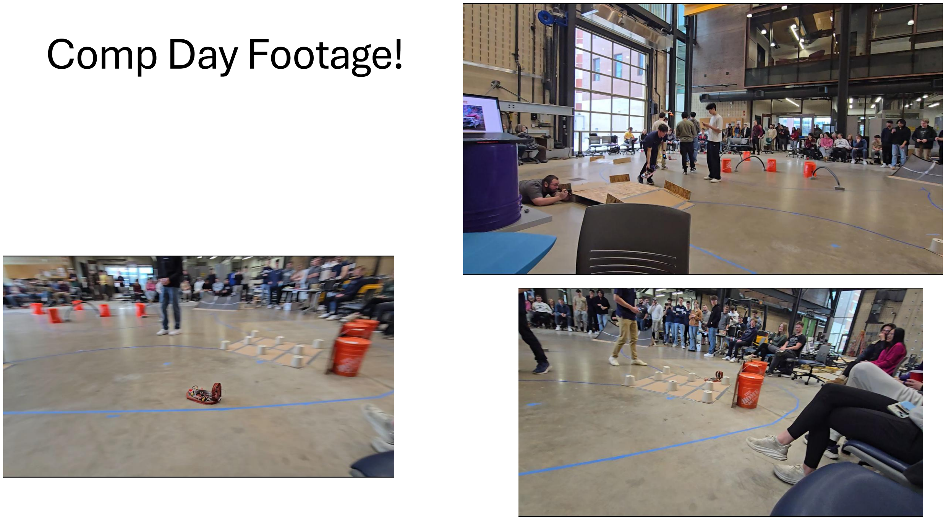
[picture p64: page 44]

# Drag Race 1

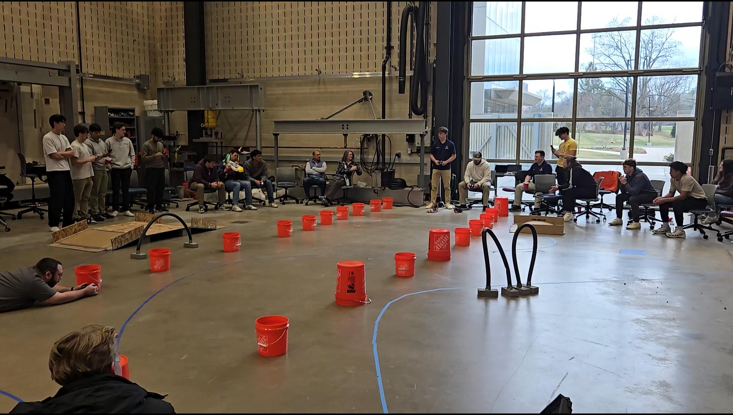
[picture p65: figure]

Spoiler… We ended up tieing so we had to redo it.

# Drag Race 2

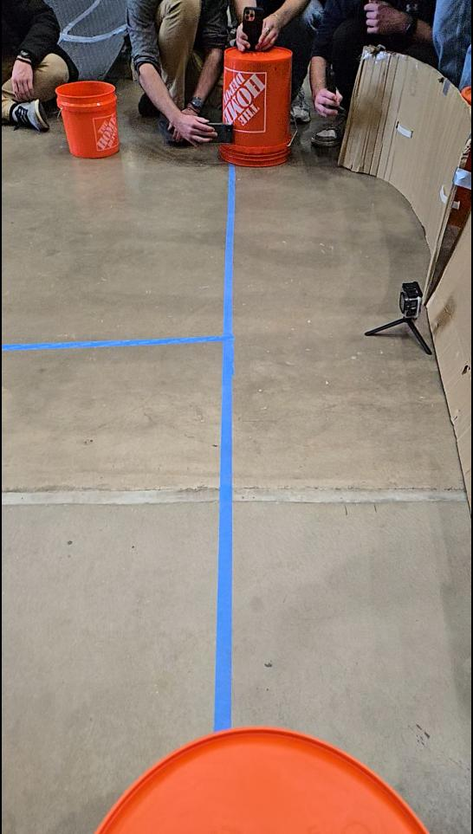
[picture p66: figure]
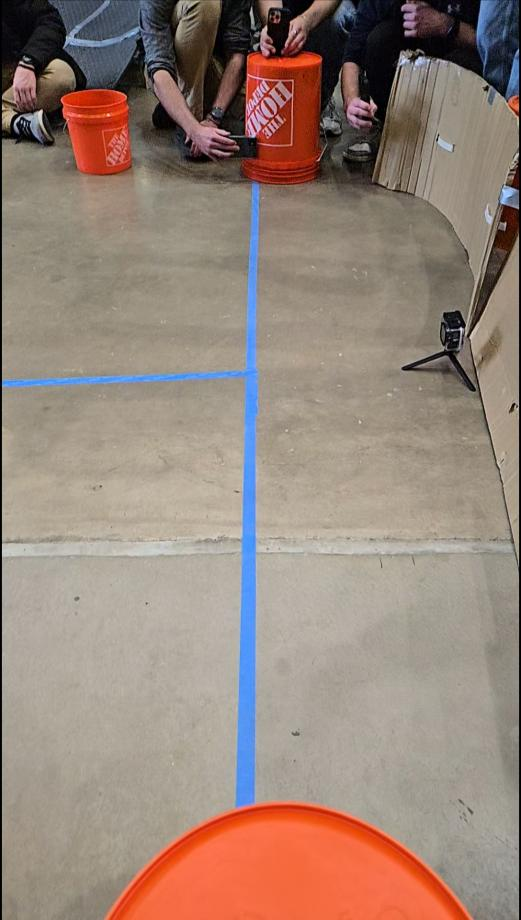
[picture p67: figure]

# Looking Good!

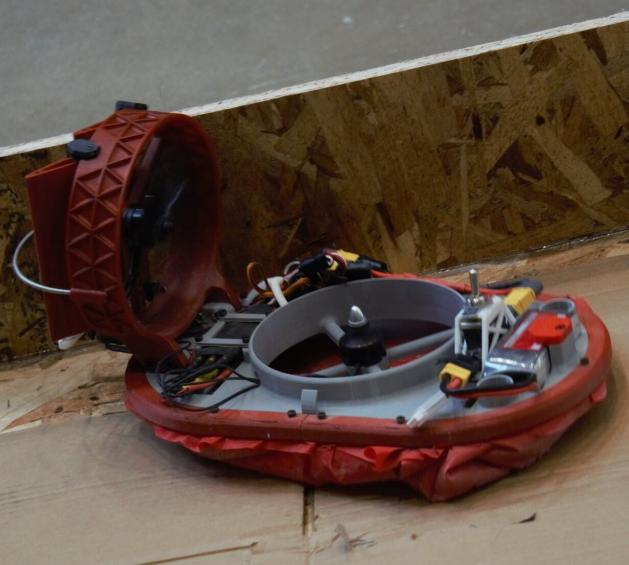
[picture p68: figure]

# The team!

That’s me!
